heatherathebyne/gemstylus/(commit log)

2019-12-08 Update sensor offsets to lap-calibrated values
2019-12-08 Add sign of life counter for EMI troubleshooting
    [gemstylus.ino]
